vherolf/rondofeed/images/rear.png

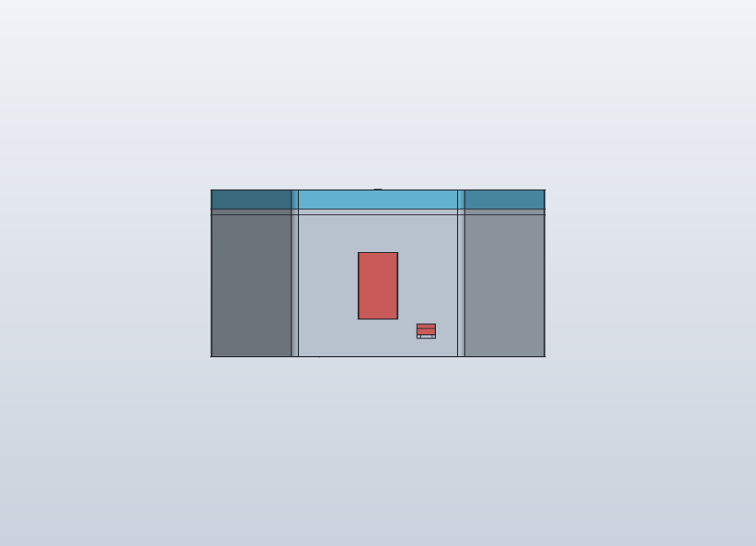
images/rear.png
