vherolf/rondofeed/images/right.png

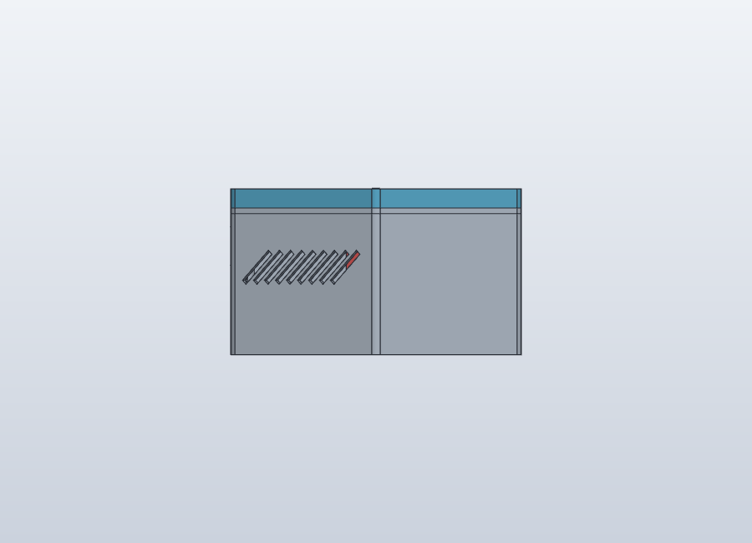
images/right.png
