vherolf/rondofeed/images/section_center.png

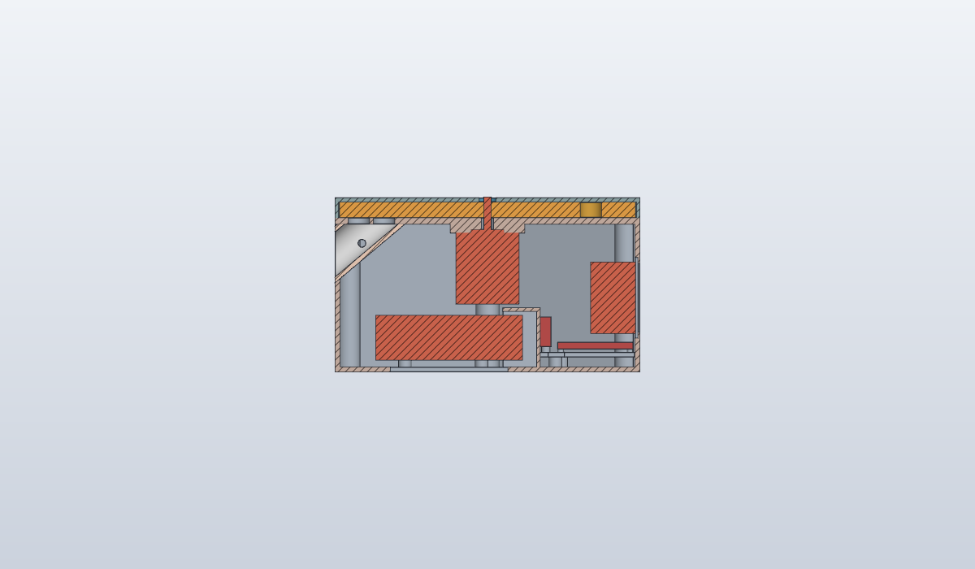
images/section_center.png
