vherolf/rondofeed/step/rondofeed.step

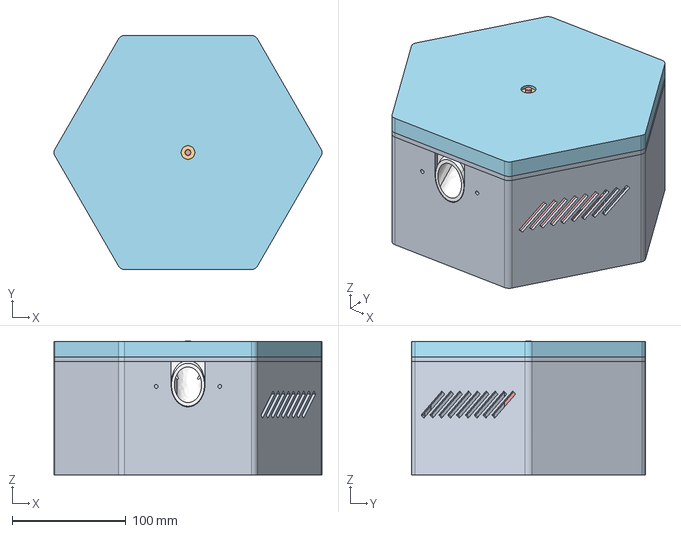
[picture p7: CAD file, 2026-11-10]
step/rondofeed.step
236.0 x 206.0 x 118.0 mm
