vherolf/rondofeed/stl/Disc_10.stl

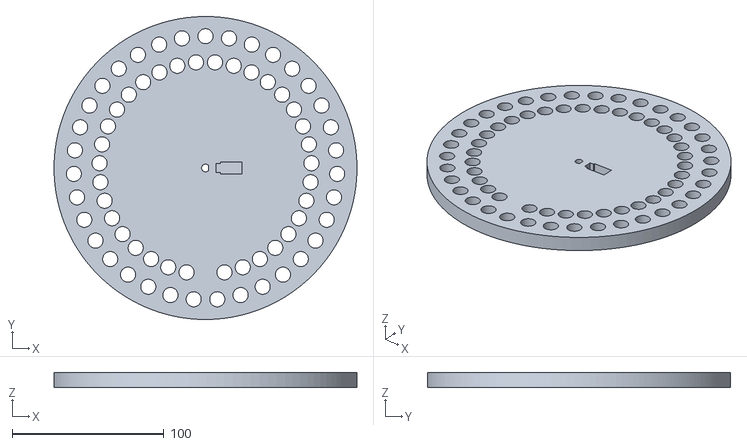
[picture p8: CAD file, 2026-11-10]
stl/Disc_10.stl
200.0 x 200.0 x 10.0
