vherolf/rondofeed/stl/Disc_12.stl

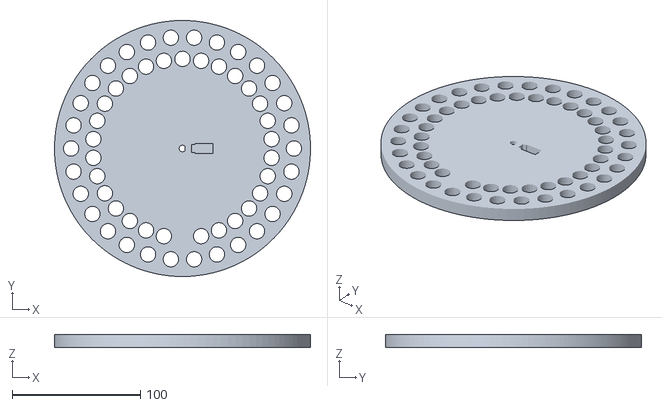
[picture p9: CAD file, 2026-11-10]
stl/Disc_12.stl
200.0 x 200.0 x 10.0
