vherolf/rondofeed/stl/Disc.stl

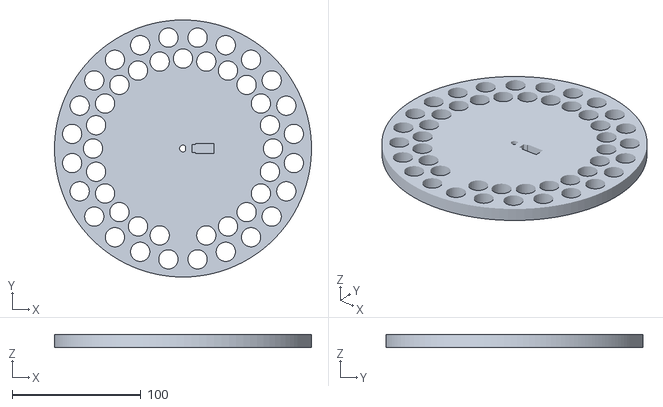
[picture p10: CAD file, 2026-11-10]
stl/Disc.stl
200.0 x 200.0 x 10.0
