vherolf/rondofeed/stl/Chute.stl

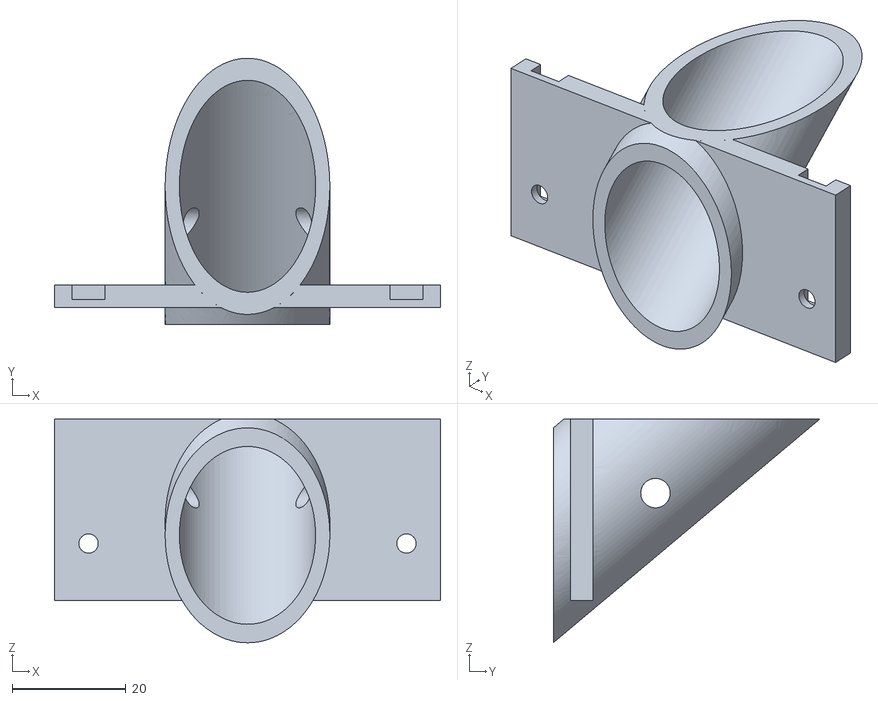
[picture p11: CAD file, 2026-11-08]
stl/Chute.stl
68.0 x 46.9 x 39.4
