vherolf/rondofeed/stl/Plate.stl

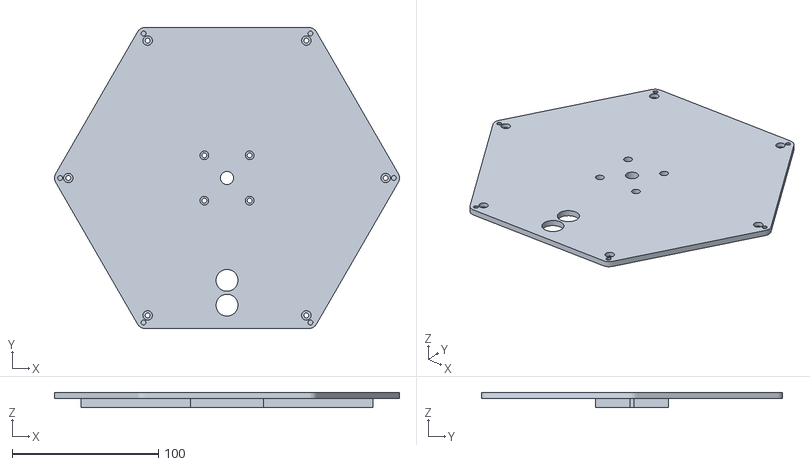
[picture p12: CAD file, 2026-11-08]
stl/Plate.stl
236.0 x 206.0 x 10.0
