vherolf/rondofeed/stl/Chute_long.stl

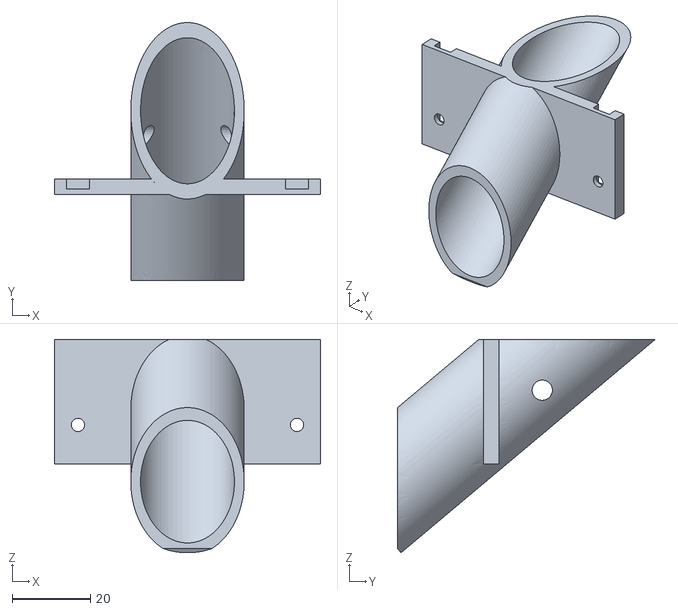
[picture p13: CAD file, 2026-11-08]
stl/Chute_long.stl
68.0 x 65.9 x 54.6
