vherolf/rondofeed/stl/Base.stl

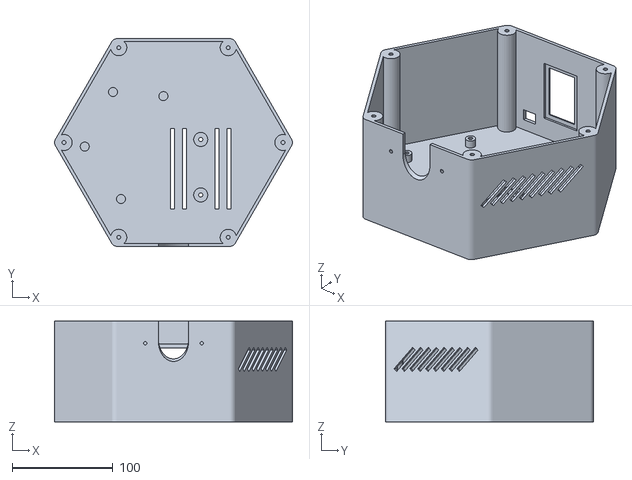
[picture p14: CAD file, 2026-11-08]
stl/Base.stl
236.0 x 206.0 x 100.0
