vherolf/rondofeed/stl/Lid.stl

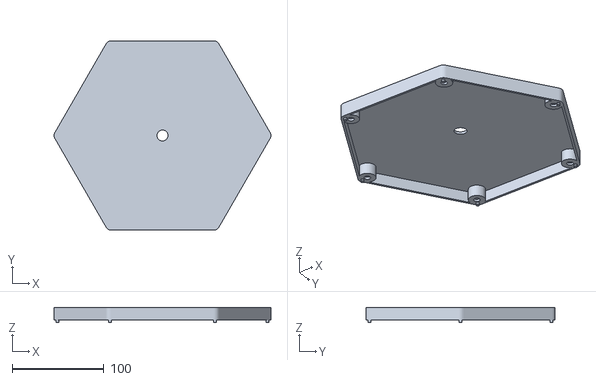
[picture p15: CAD file, 2026-11-08]
stl/Lid.stl
236.0 x 206.0 x 16.0
