vherolf/rondofeed/stl/Carrier.stl

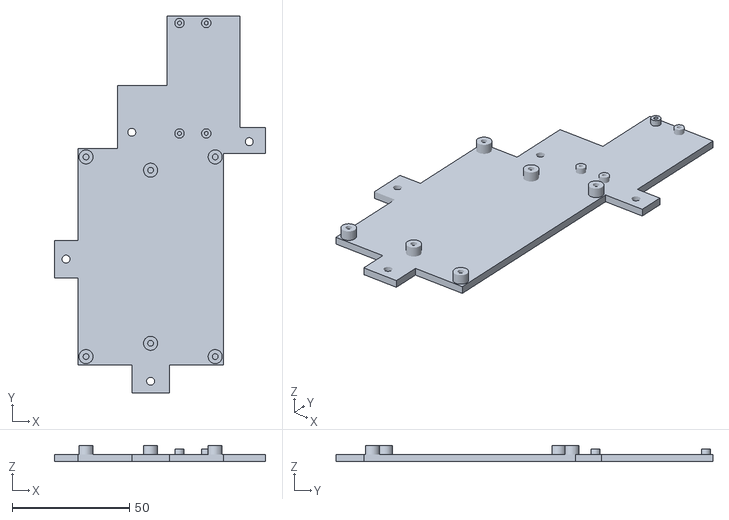
[picture p16: CAD file, 2026-11-05]
stl/Carrier.stl
90.0 x 160.5 x 7.00
