vherolf/rondofeed/stl/Chute_short.stl

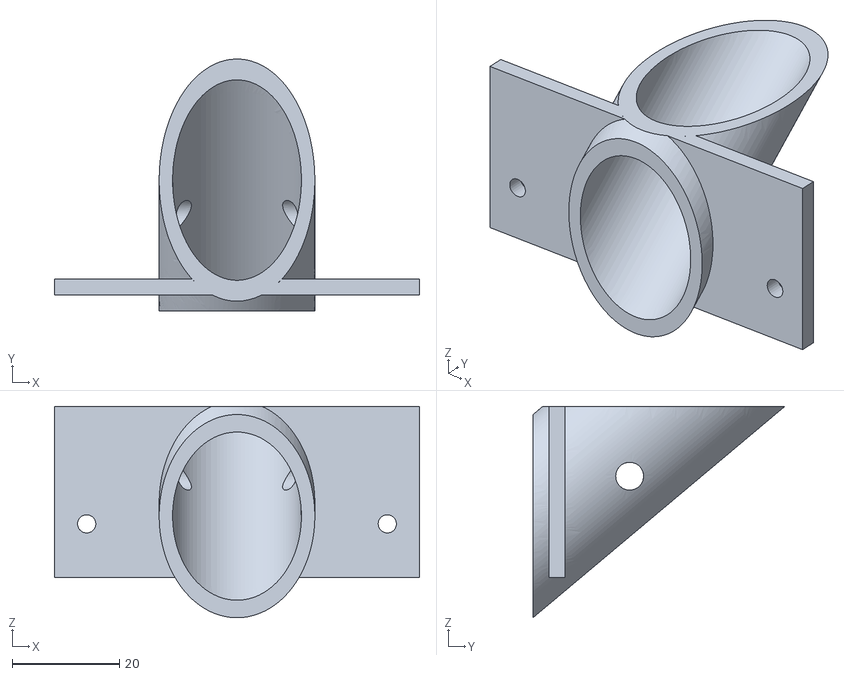
[picture p17: CAD file, 2026-11-01]
stl/Chute_short.stl
68.0 x 46.9 x 39.4
