vherolf/rondofeed/stl/TerminalCover.stl

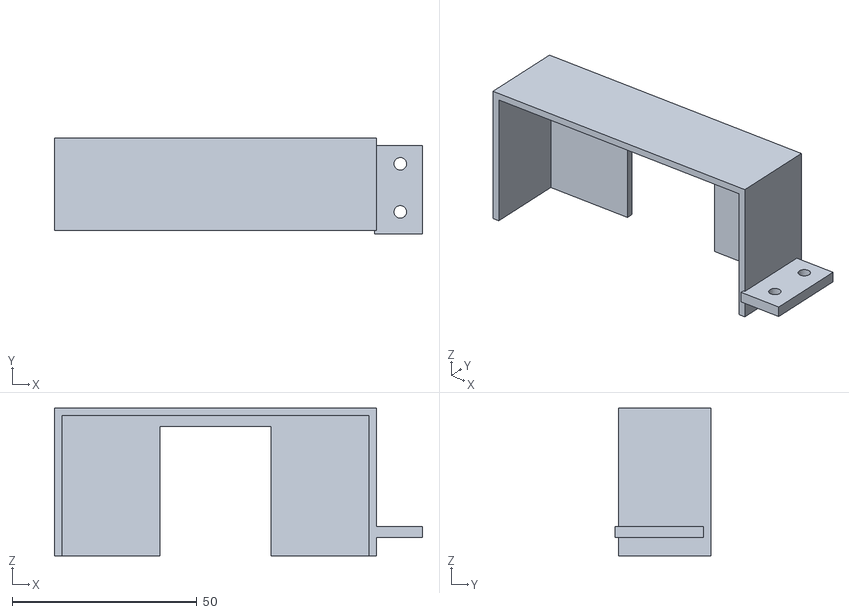
[picture p18: CAD file, 2026-11-01]
stl/TerminalCover.stl
99.5 x 26.0 x 40.0
