vherolf/rondofeed/stl/Cap.stl

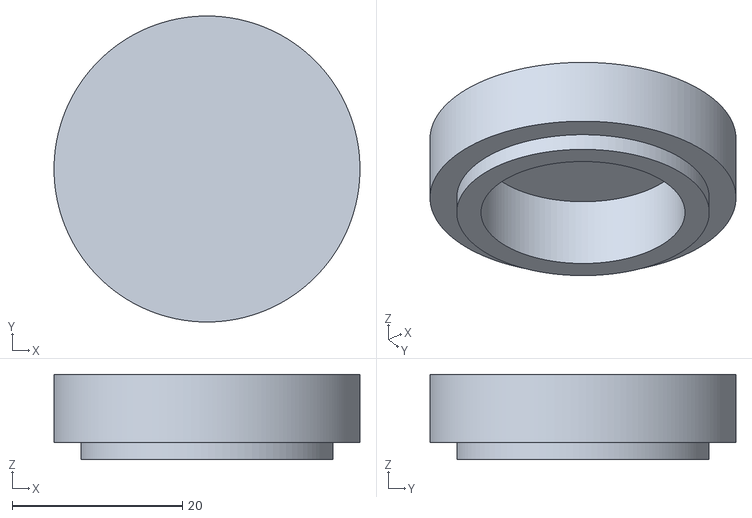
[picture p19: CAD file, 2026-10-31]
stl/Cap.stl
36.0 x 36.0 x 10.0
