vherolf/rondofeed/(commit log)

2026-10-31 rondOfeed 0.2
    Open, 3D-printable automatic feeder for dogs, birds and other pets.
    Hardware under CERN-OHL-P 2.0, software under Apache-2.0 OR MIT.
2026-10-31 Add wiring layout for the Perma-Proto board and housing
    Hole positions come from the Adafruit PCB files. Correct the board
    size and the mounting hole axis in the docs.
2026-11-01 Make the housing a hexagon
    Hexagonal housing and plate, 206 mm across the flats, flat walls front
    and back so chute, IEC inlet and USB stay on plane walls. The round lid
    is kept and touches the flats. Plate screws sit in three corners, the
    lid tabs in the other three.
    Power supply moves to the slanted rear right wall, the carrier is split
    into two parts, Pico and Perma-Proto board move to the left rear.
    No interferences between the bodies. STLs, images and README updated.
2026-11-01 Redraw the wiring layout for the hexagonal housing
    The Perma-Proto board now lies with its long side along X, so the
    mounting holes sit on the short axis as on the real board. Carrier
    holes moved to leave room for the Pico wires. STLs, images and notes
    updated.
2026-11-01 Add STEP export for other CAD programs
2026-11-01 rondOfeed 0.3
    Hexagonal housing, redrawn wiring layout, STEP export.
2026-11-01 Remove the cap, shrink the shaft hole in the lid to Ø12
    The shaft end sticks out of the lid by about 0.5 mm and now only the
    hole for it remains. STL, STEP and images updated.
2026-11-01 Move the power supply to the floor, hexagonal lid, 6 screws
    The power supply lies flat on two pads, screwed from below, with floor
    slots below and slots in the right front wall above. All six corners
    have a dome: one M3x20 holds lid, plate and housing. The lid is now a
    hexagon like the housing. Terminal cover, wiring layout, STL, STEP,
    images and README updated.
2026-11-01 Hold the lid with magnets over the plate screws
    Six Ø6 x 2 mm magnets sit in closed pockets in the lid corners, each
    over a steel M3x8 plate screw. The lid has no holes on top. The plate
    gets counterbores for the screw heads. STL, STEP, images and README
    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
2026-11-01 Add guide pins between lid and plate
    Six Ø3 mm pins under the lid corner domes fit into holes in the plate,
    so the lid cannot slide sideways. The pins point up when the lid is
    printed with its top on the bed. Lid domes are Ø16 now.
2026-11-01 rondOfeed 0.4
    Power supply on the floor, hexagonal lid held by magnets with guide pins,
    no cap, redrawn wiring layout.
2026-11-01 Add MicroPython firmware: USB serial and BLE commands
    Feeder core with position, limits and light barrier check, a line
    protocol shared by USB and BLE, PIO step pulses and flash state.
    The core is tested on a PC, the hardware part has not run on a board.
2026-11-01 Fix MicroPython issues found on a Pico W
    Exception.__init__ does not exist in MicroPython, so an error in a
    command ended the main loop. Commands now answer ERR internal instead.
    BLE writes were cut at 20 bytes, the receive buffer is 128 bytes now.
    USB serial and BLE are tested on a board, without motor.
2026-11-01 rondOfeed 0.5
    MicroPython firmware with USB serial and BLE commands, tested on a Pico W
    without motor. Firmware to-do list in PLAN.md.
2026-11-01 Fix step pulses on MicroPython, add readable BLE names
    StateMachine has no freq method in MicroPython, so every move failed.
    The rate is set with init per segment now. The two BLE characteristics
    get a user description for tools like nRF Connect. Tested on a Pico W
    without motor: whole feed sequence, pulse timing, uncertain state after
    a cut-off move.
2026-11-01 BLE: add Device Information Service, appearance and device name
    Manufacturer, model and firmware version come from the standard Device
    Information Service. The advertisement carries the category Domestic
    Appliance, the Generic Access name is rondOfeed instead of MPY BTSTACK.
    Tested on a Pico W from a PC.
2026-11-01 Store: replace the state file in one step
    save() removed the old file before renaming the new one. An interruption
    in between lost the position and the BLE token. rename now replaces the
    file, and the temporary file is only read if the main file is missing.
    Tested with ten interrupted moves on a Pico W, plus new tests.
2026-11-01 rondOfeed 0.6
    Firmware: fixed step pulses on MicroPython, BLE names and Device
    Information Service, state file replaced in one step.
2026-11-01 Parts list and drawings: Pico W or Pico 2 W
2026-11-01 Wiring layout: move the motor cable label next to the plug
2026-11-01 Add Chute_short: a chute that ends flush with the housing
    Same opening, screws and light barrier holes as the standard chute, but
    cut off at the outer wall so nothing sticks out. The lowest edge is
    about 72 mm above the table, so the bowl can be higher. Built from
    build.py like the extra discs, no interference with the housing.
2026-11-01 Make the short chute the default, keep the long one as Chute_long
    The short chute ends flush with the housing. The long one, which sticks
    out 19 mm, is an option now. Images, STEP and README updated.
2026-11-01 rondOfeed 0.7
    Short chute as default, long one as option. Plan and parts list for Pico W.
2026-11-02 Half-size prototyping board, discrete light barrier, IEC cutout 28 × 47 mm
    The carrier now takes a half-size board lengthwise, with posts for the
    Adafruit Perma-Proto Half-Size and the GeeekPi Half-Size. The light
    barrier is an IR LED and a phototransistor in the Ø5.2 mm holes, with
    R2 and R3 on the board, so BEAM_BROKEN_LEVEL is 1. Wiring layout
    redrawn for the half-size board, schematic updated. The parts list
    names a European IEC inlet with a T1A fuse, and the cutout is 28 × 47 mm.
2026-11-02 Thin the rear wall to 2 mm around the IEC cutout
    Snap-in clips of IEC inlets are often made for 1–2 mm panels. A pocket
    on the inside leaves 2 mm (IEC_WALL) for 7 mm around the cutout
    (IEC_RIM), the outside stays flat and the rest of the wall stays 3 mm.
2026-11-05 Use M3x8 screws everywhere
    All fastener lengths unified to steel M3x8 (plate, motor, power supply,
    carrier, terminal cover, chute, prototyping board, disc set screw). Pico
    keeps M2x5. Motor screw recess 5.5 mm, insert holes 8 mm deep, chute plate
    4 mm with captive nut slots. README, STL, STEP and images regenerated.
2026-11-08 Base 100 mm high, IEC pocket 1 mm wall and 4 mm rim
    Base is 12 mm lower (BASE_H 112 -> 100); the chute ears follow it (EAR_Z = BASE_H - 22).
    The motor stays 48 mm long and ends 3 mm above the terminal cover. The rear wall
    is 1 mm thick (IEC_WALL) for 4 mm (IEC_RIM) around the IEC cutout. Bowl height under
    the chute drops to about 58 mm (Chute_long 45 mm). README, PLAN, STL, STEP and images
    regenerated.
2026-11-10 D-shaped bore in the disc for the flat on the NEMA 17 shaft
    The bore was round, so only the set screw kept the disc from slipping.
    It now follows the D-shaft: Ø5.2 mm with the flat 4.6 mm from the
    opposite side (SHAFT_FLAT, 4.5 mm plus clearance), facing +X so the set
    screw presses on the flat. Applies to Disc, Disc_12 and Disc_10.
    README explains how to tune SHAFT_D and SHAFT_FLAT after the test print.
